hotchk155/noodlebox_io_board/matrix_io_board.brd

## EAGLE design matrix_io_board.brd (2020-02-26)

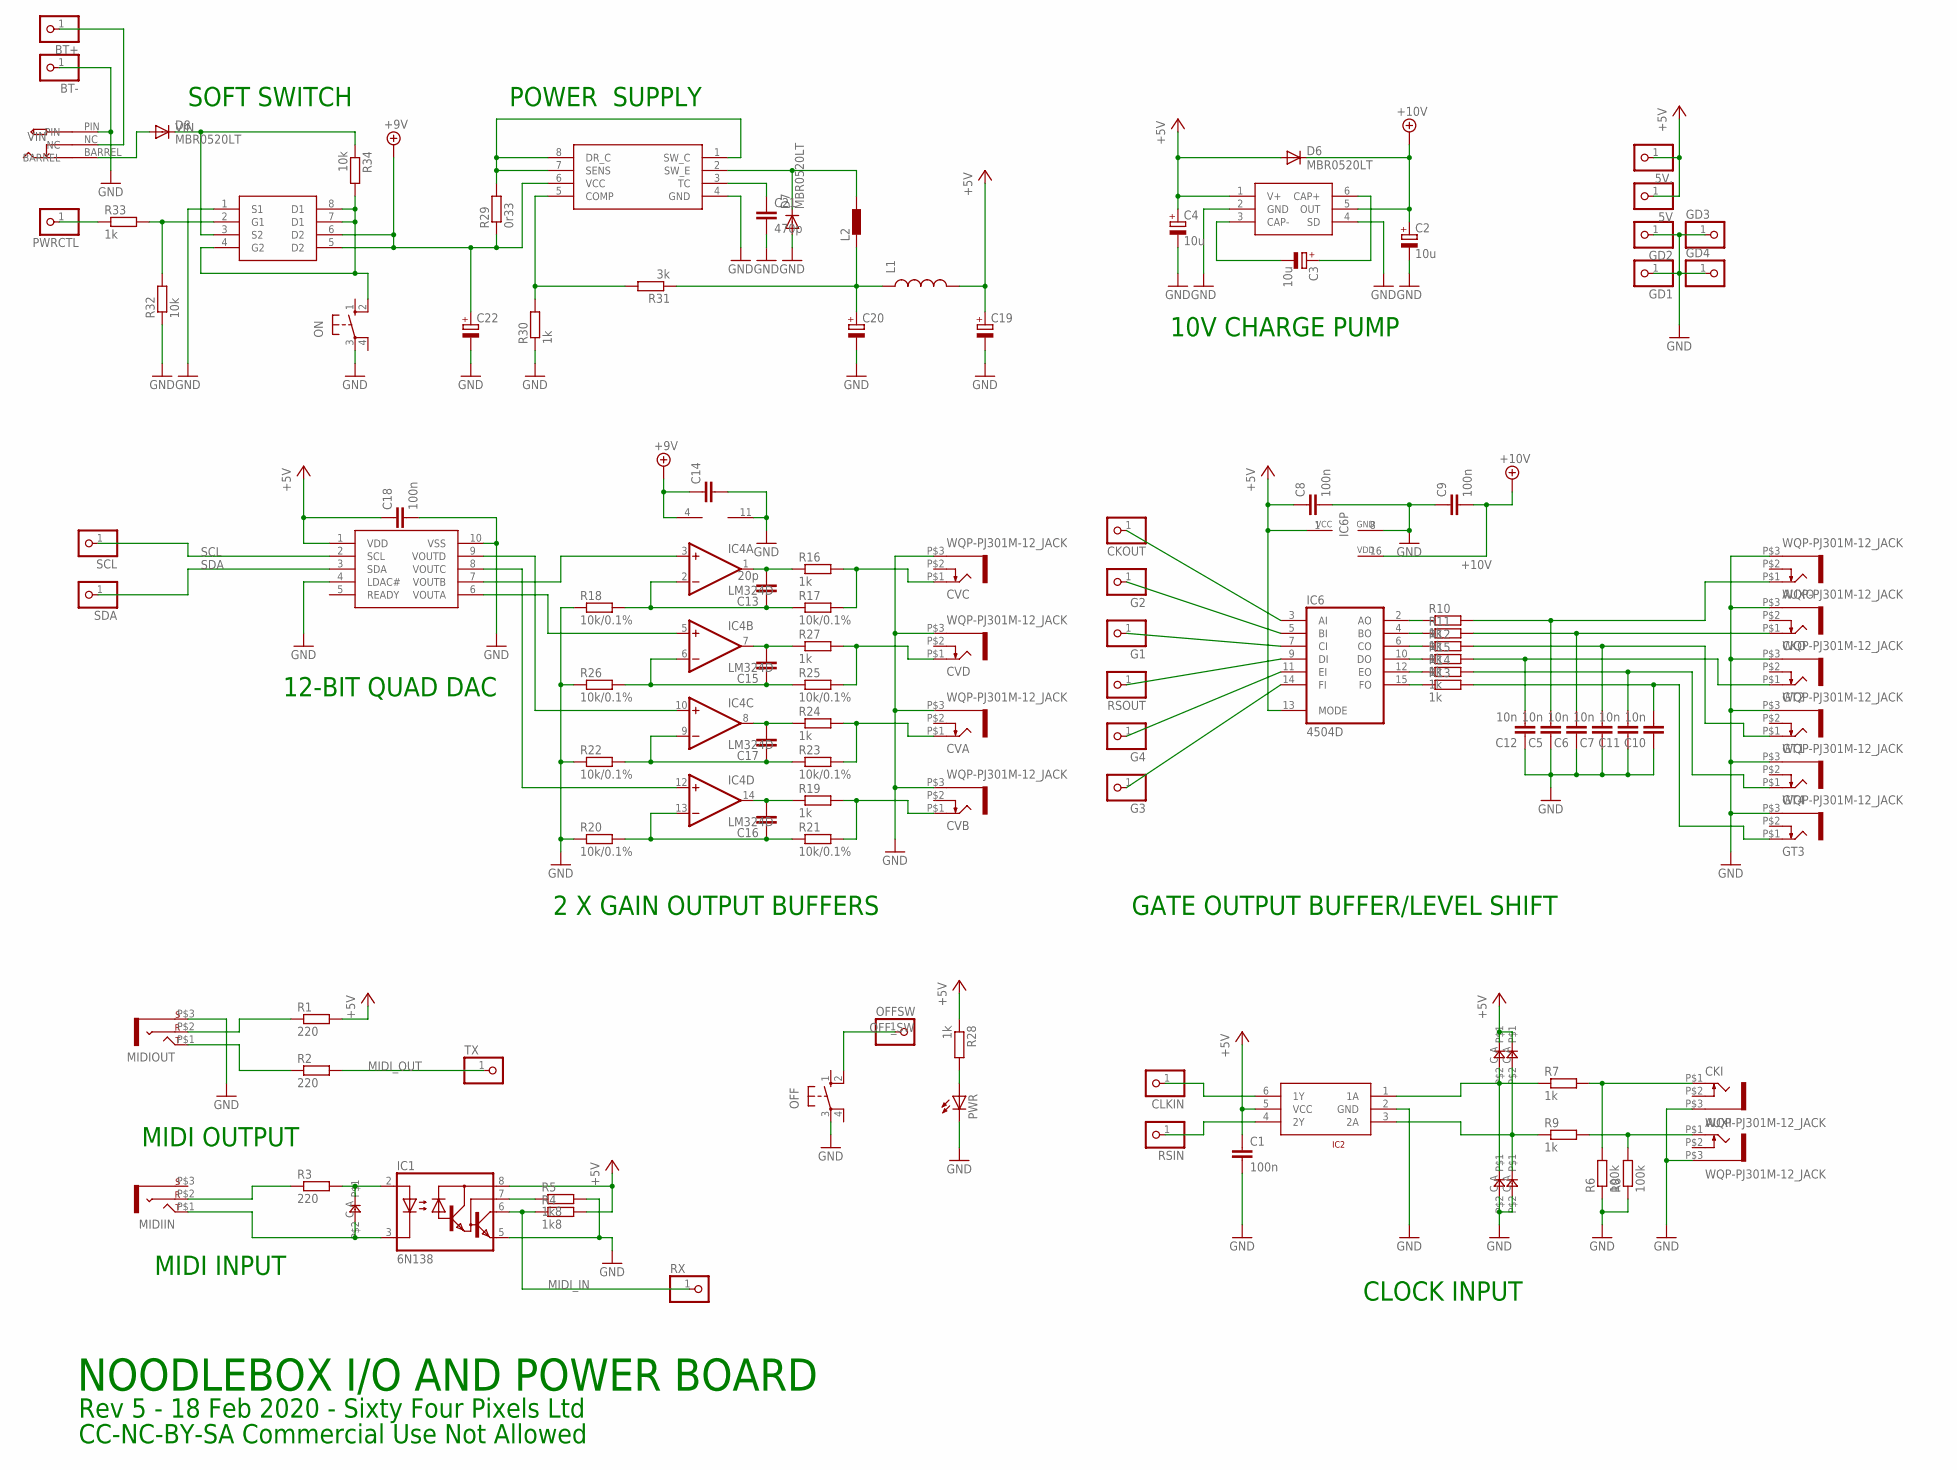
[picture p1: schematic matrix_io_board.sch]

Parts:
5V, 5V.: PINHD-1X1; 1X01
AUXI: WQP-PJ301M-12_JACK
AUXO: WQP-PJ301M-12_JACK
BT+: PINHD-1X1; 1X01
BT-: PINHD-1X1; 1X01
C1, C8, C9, C18: 100n; C0805
C2, C3, C4: 10u; SMC_A
C5, C6, C7, C10, C11, C12: 10n; C0805
C13: 20p; C0805
C14, C15, C16, C17: C-EUC0805; C0805
C19, C20, C22: CPOL-EUD; PANASONIC_D
C21: 470p; C0805
CKI: WQP-PJ301M-12_JACK
CKO: WQP-PJ301M-12_JACK
CKOUT: PINHD-1X1; 1X01
CLKIN: PINHD-1X1; 1X01
CVA: WQP-PJ301M-12_JACK
CVB: WQP-PJ301M-12_JACK
CVC: WQP-PJ301M-12_JACK
CVD: WQP-PJ301M-12_JACK
D1, D2, D3, D4, D5: 0805DIODE
D6, D7, D8: MBR0520LT; SOD123
DC: PWR_SOCKET_2_1MM
G1, G2, G3, G4: PINHD-1X1; 1X01
GD1, GD2, GD3, GD4: PINHD-1X1; 1X01
GT1, GT2, GT3, GT4: WQP-PJ301M-12_JACK
IC1: 6N138; DIL08
IC2: SN74LVC2G14; DBV_R-PDSO-G6
IC3: LM27675M5_CHARGEPUMP; SOT23-6
IC4: LM324D; SO14
IC5: MCP4728_QUAD_DAC; MSOP10
IC6: 4504D; SO16
IC7: SP34063A_BOOST_REG; SOIC8
IC8: FDS8958B; SOIC8
L1: INDUCTOR1210; 1210
L2: NB_IND; DR1030
MIDIIN: THONKICONN_STEREO; WQP-PJ301M-ST
MIDIOUT: THONKICONN_STEREO; WQP-PJ301M-ST
OFF: 10-XX; B3F-10XX
OFFSW: PINHD-1X1; 1X01
ON: 10-XX; B3F-10XX
PWR: LED3MM
PWRCTL: PINHD-1X1; 1X01
R1, R2, R3: 220; R0805
R4, R5: 1k8; R0805
R6, R8: 100k; R0805
R7, R9, R10, R11, R12, R13, R14, R15, R16, R19, R24, R27, R28, R30, R33: 1k; R0805
R17, R18, R20, R21, R22, R23, R25, R26: 10k/0.1%; R0805
R29: 0r33; R0805
R31: 3k; R0805
R32, R34: 10k; R0805
RSIN: PINHD-1X1; 1X01
RSOUT: PINHD-1X1; 1X01
RX: PINHD-1X1; 1X01
SCL: PINHD-1X1; 1X01
SDA: PINHD-1X1; 1X01
TX: PINHD-1X1; 1X01

Connections:
+5V: 5V.1, 5V..1, C1.1, C4.+, C8.1, C18.1, C19.+, D3.A, D4.A, D6.A, IC1.8 (VCC), IC2.5 (VCC), IC3.1 (V+), IC5.1 (VDD), IC6.1 (VCC), IC6.13 (MODE), L1.2, R1.2, R4.2, R28.1
+9V: C14.1, C22.+, IC4.4 (V+), IC7.6 (VCC), IC8.5 (D2), IC8.6 (D2), R29.1
+10V: C2.+, C9.2, D6.C, IC3.5 (OUT), IC6.16 (VDD)
AUXGATE: IC6.9 (DI), RSOUT.1
CLKOUT: CKOUT.1, IC6.3 (AI)
GATE1: G3.1, IC6.14 (FI)
GATE2: G2.1, IC6.5 (BI)
GATE3: G1.1, IC6.7 (CI)
GATE4: G4.1, IC6.11 (EI)
GND: AUXI.P$3 (1), AUXO.P$3 (1), BT-.1, C1.2, C2.-, C4.-, C5.1, C6.1, C7.1, C8.2, C9.1, C10.1, C11.1, C12.1, C14.2, C18.2, C19.-, C20.-, C21.2, C22.-, CKI.P$3 (1), CKO.P$3 (1), CVA.P$3 (1), CVB.P$3 (1), CVC.P$3 (1), CVD.P$3 (1), D2.C, D5.C, D7.A, DC.PIN, GD1.1, GD2.1, GD3.1, GD4.1, GT1.P$3 (1), GT2.P$3 (1), GT3.P$3 (1), GT4.P$3 (1), IC1.5 (GND), IC2.2 (GND), IC3.2 (GND), IC3.4 (SD), IC4.11 (V-), IC5.4 (LDAC#), IC5.10 (VSS), IC6.8 (GND), IC7.4 (GND), IC8.1 (S1), MIDIOUT.P$3 (S), OFF.3, ON.3, PWR.K (C), R5.2, R6.1, R8.1, R18.1, R20.1, R22.1, R26.1, R30.1, R32.1
MIDI_IN: IC1.6 (VO), R4.1, RX.1
MIDI_OUT: R2.2, TX.1
unnamed: MIDIOUT.P$2 (R), R1.1
unnamed: D1.A, IC1.2 (A), R3.2
unnamed: IC4.3 (+IN), IC5.7 (VOUTB)
unnamed: D1.C, IC1.3 (C), MIDIIN.P$1 (T)
unnamed: IC1.7 (VB), R5.1
unnamed: MIDIOUT.P$1 (T), R2.1
unnamed: MIDIIN.P$2 (R), R3.1
unnamed: CVC.P$1 (2), R16.2, R17.2
unnamed: CVD.P$1 (2), R25.2, R27.2
unnamed: CVB.P$1 (2), R19.2, R21.2
unnamed: CVA.P$1 (2), R23.2, R24.2
unnamed: C13.2, IC4.1 (OUT), R16.1
unnamed: C15.2, IC4.7 (OUT), R27.1
unnamed: C17.2, IC4.8 (OUT), R24.1
unnamed: C16.2, IC4.14 (OUT), R19.1
unnamed: BT+.1, DC.NC
unnamed: C16.1, IC4.13 (-IN), R20.2, R21.1
unnamed: C17.1, IC4.9 (-IN), R22.2, R23.1
unnamed: IC6.10 (DO), R15.1
unnamed: C15.1, IC4.6 (-IN), R25.1, R26.2
unnamed: C13.1, IC4.2 (-IN), R17.1, R18.2
unnamed: CLKIN.1, IC2.6 (1Y)
unnamed: AUXI.P$1 (2), R8.2, R9.2
unnamed: IC2.4 (2Y), RSIN.1
unnamed: D4.C, D5.A, IC2.3 (2A), R9.1
unnamed: C12.2, GT2.P$1 (2), R15.2
unnamed: IC4.5 (+IN), IC5.6 (VOUTA)
unnamed: IC4.10 (+IN), IC5.9 (VOUTD)
unnamed: IC4.12 (+IN), IC5.8 (VOUTC)
unnamed: IC7.1 (SW_C), IC7.7 (SENS), IC7.8 (DR_C), R29.2
unnamed: IC7.5 (COMP), R30.2, R31.2
unnamed: C21.1, IC7.3 (TC)
unnamed: D7.C, IC7.2 (SW_E), L2.2
unnamed: D8.A, DC.BARREL
unnamed: IC6.2 (AO), R10.1
unnamed: C3.+, IC3.6 (CAP+)
unnamed: C3.-, IC3.3 (CAP-)
unnamed: IC6.4 (BO), R11.1
unnamed: IC6.6 (CO), R12.1
unnamed: IC6.12 (EO), R14.1
unnamed: AUXO.P$1 (2), C5.2, R10.2
unnamed: C6.2, CKO.P$1 (2), R11.2
unnamed: C7.2, GT1.P$1 (2), R12.2
unnamed: C11.2, GT4.P$1 (2), R14.2
unnamed: C10.2, GT3.P$1 (2), R13.2
unnamed: IC6.15 (FO), R13.1
unnamed: C20.+, L1.1, L2.1, R31.1
unnamed: D2.A, D3.C, IC2.1 (1A), R7.1
unnamed: CKI.P$1 (2), R6.2, R7.2
unnamed: PWR.A, R28.2
unnamed: IC8.4 (G2), IC8.7 (D1), IC8.8 (D1), ON.2 (S1), R34.2
unnamed: IC8.2 (G1), R32.2, R33.2
OFF_SW: OFF.2 (S1), OFFSW.1
PWR_CTRL: PWRCTL.1, R33.1
SCL: IC5.2 (SCL), SCL.1
SDA: IC5.3 (SDA), SDA.1
VIN: D8.C, IC8.3 (S2), R34.1

Notes on the sheet:
POWER SUPPLY
SOFT SWITCH
2 X GAIN OUTPUT BUFFERS
12-BIT QUAD DAC
GATE OUTPUT BUFFER/LEVEL SHIFT
10V CHARGE PUMP
MIDI INPUT
MIDI OUTPUT
CLOCK INPUT
NOODLEBOX I/O AND POWER BOARD
Rev 5 - 18 Feb 2020 - Sixty Four Pixels Ltd
CC-NC-BY-SA Commercial Use Not Allowed

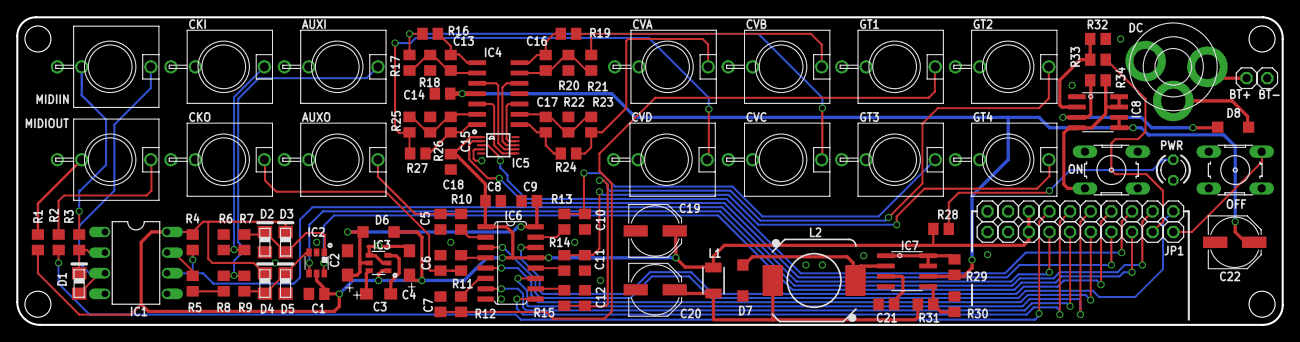
[picture p2: board matrix_io_board.brd from above]

Board: 2 copper layers, 155.7 x 37.8 mm, 114 parts (0 on the bottom side), 69 nets.
