hotchk155/noodlebox_io_board/lower-board.brd

## EAGLE design lower-board.brd (2018-07-10)

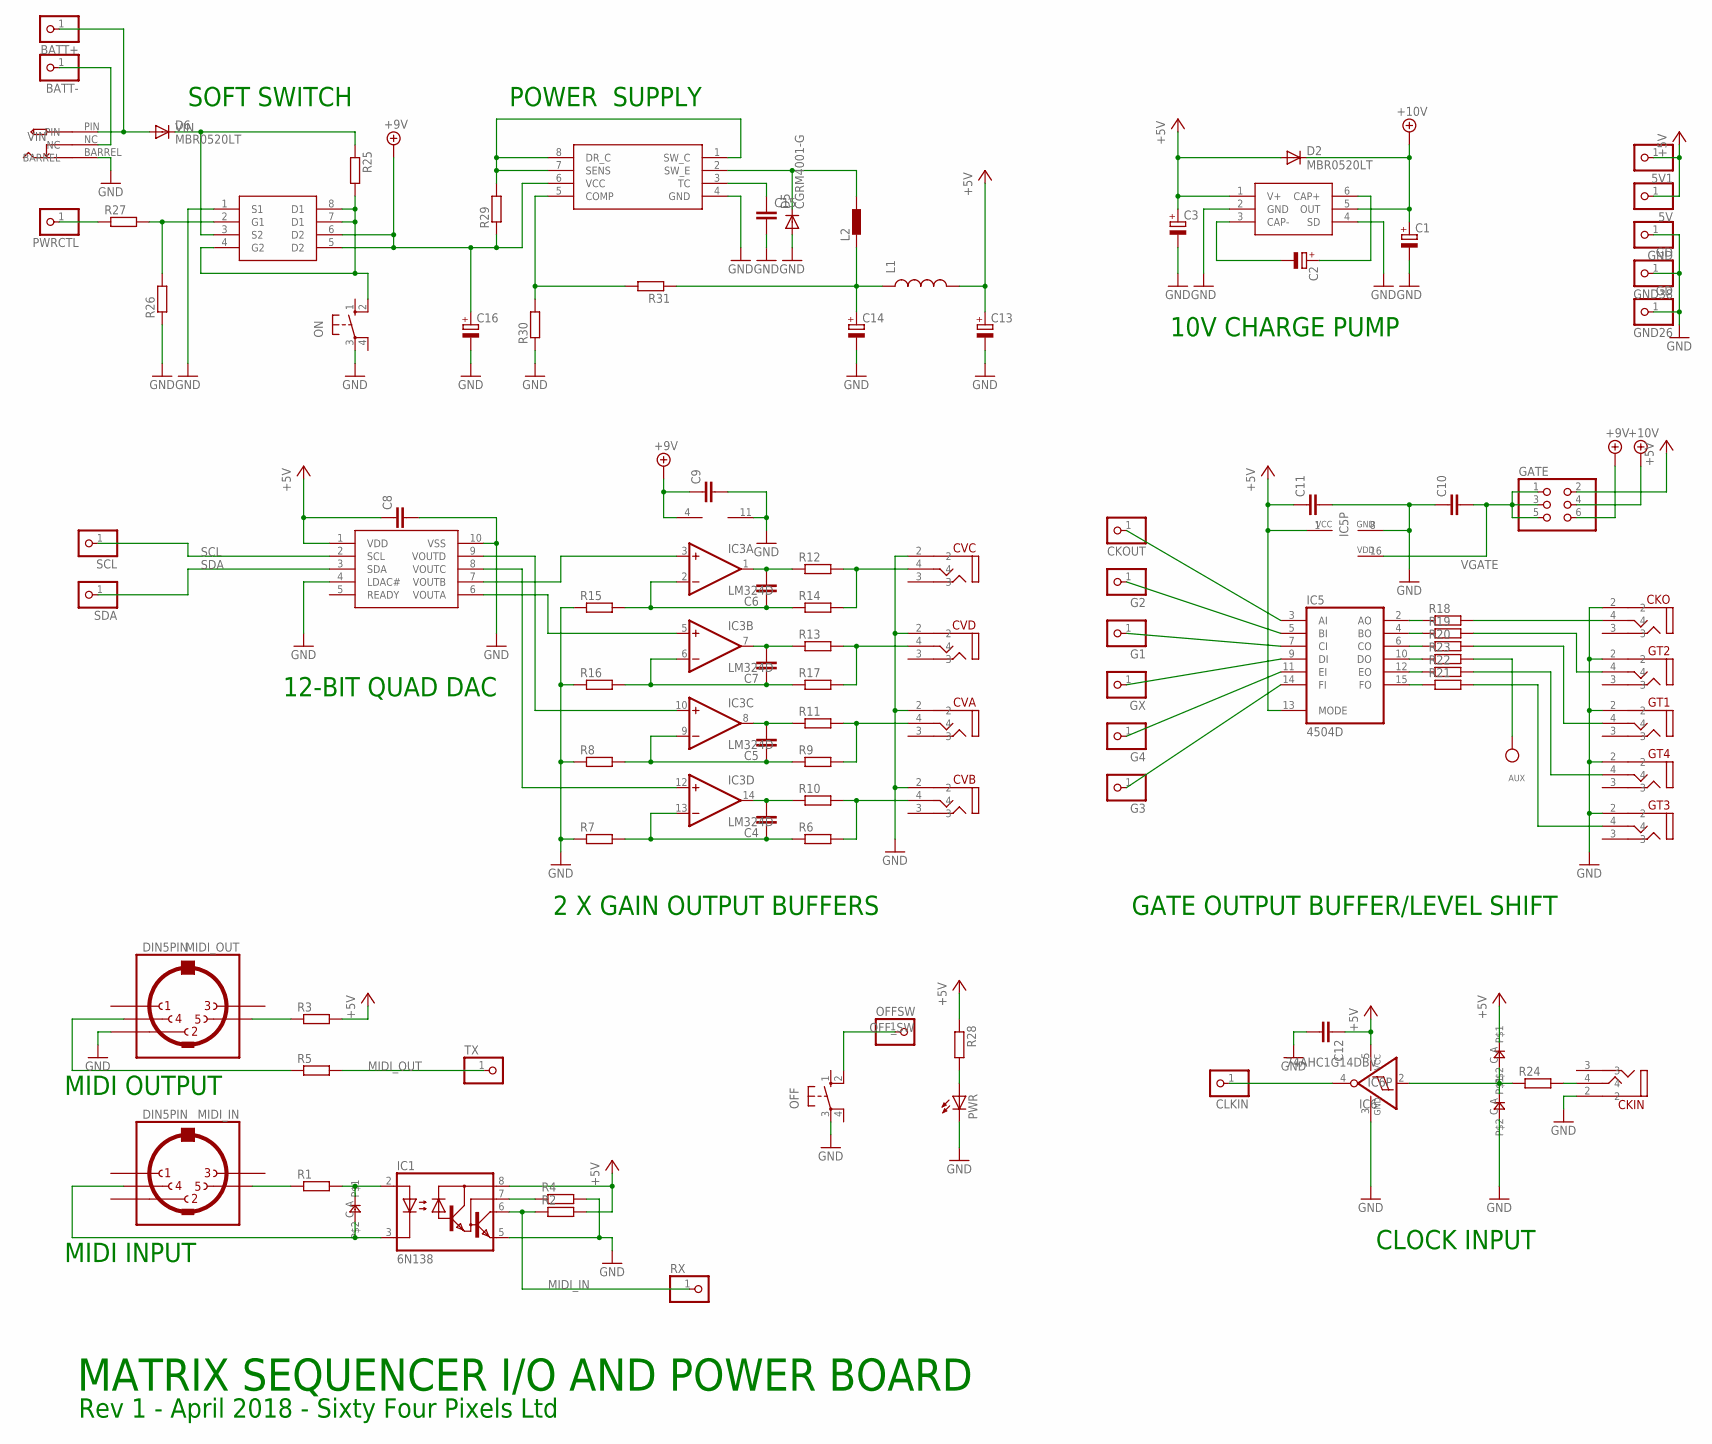
[picture p3: schematic lower-board.sch]

Parts:
5V, 5V1: PINHD-1X1; 1X01
AUX: TESTPOINTROUND2MM; TESTPOINT_ROUND_2MM
BATT+: PINHD-1X1; 1X01
BATT-: PINHD-1X1; 1X01
C1, C2, C3: CPOL-EUSMCA; SMC_A
C4, C5, C6, C7, C8, C9, C10, C11, C12, C15: C-EUC0805; C0805
C13, C14, C16: CPOL-EUE2.5-7; E2,5-7
CKIN: VERTICAL_3_5MM_SOCKET
CKO: VERTICAL_3_5MM_SOCKET
CKOUT: PINHD-1X1; 1X01
CLKIN: PINHD-1X1; 1X01
CVA: VERTICAL_3_5MM_SOCKET
CVB: VERTICAL_3_5MM_SOCKET
CVC: VERTICAL_3_5MM_SOCKET
CVD: VERTICAL_3_5MM_SOCKET
D1, D3, D4: 0805DIODE
D2, D6: MBR0520LT; SOD123
D5: CGRM4001-G; SOD-123_MINI-SMA
G1, G2, G3, G4: PINHD-1X1; 1X01
GATE: PINHD-2X3; 2X03
GND: PINHD-1X1; 1X01
GND26, GND38: GD; 1X01
GT1, GT2, GT3, GT4: VERTICAL_3_5MM_SOCKET
GX: PINHD-1X1; 1X01
IC1: 6N138; DIL08
IC2: LM27675M5_CHARGEPUMP; SOT23-6
IC3: LM324D; SO14
IC4: MCP4728_QUAD_DAC; MSOP10
IC5: 4504D; SO16
IC6: 74AHC1G14DBV; SOT23-5
IC7: FDS8958B; SOIC8
IC8: SP34063A_BOOST_REG; SOIC8
L1: INDUCTOR1210; 1210
L2: DR1030
MIDI_IN: DIN5PIN; EDGEDIN
MIDI_OUT: DIN5PIN; EDGEDIN
OFF: 10-XX; B3F-10XX
OFFSW: PINHD-1X1; 1X01
ON: 10-XX; B3F-10XX
PWR: LED3MM
PWRCTL: PINHD-1X1; 1X01
R1, R2, R3, R4, R5, R6, R7, R8, R9, R10, R11, R12, R13, R14, R15, R16, R17, R18, R19, R20, R21, R22, R23, R24, R25, R26, R27, R28, R29, R30, R31: R-EU_R0805; R0805
RX: PINHD-1X1; 1X01
SCL: PINHD-1X1; 1X01
SDA: PINHD-1X1; 1X01
TX: PINHD-1X1; 1X01
U$1: PWR_SOCKET_2_1MM

Connections:
+5V: 5V.1, 5V1.1, C3.+, C8.1, C11.1, C12.1, C13.+, D2.A, D3.A, GATE.2, IC1.8 (VCC), IC2.1 (V+), IC4.1 (VDD), IC5.1 (VCC), IC5.13 (MODE), IC6.5 (VCC), L1.2, R2.2, R3.2, R28.1
+9V: C9.1, C16.+, GATE.6, IC3.4 (V+), IC7.5 (D2), IC7.6 (D2), IC8.6 (VCC), R29.1
+10V: C1.+, D2.C, GATE.4, IC2.5 (OUT)
AUXGATE: GX.1, IC5.9 (DI)
CLKIN: CLKIN.1, IC6.4 (O)
CLKOUT: CKOUT.1, IC5.3 (AI)
GATE1: G3.1, IC5.14 (FI)
GATE2: G2.1, IC5.5 (BI)
GATE3: G1.1, IC5.7 (CI)
GATE4: G4.1, IC5.11 (EI)
GND: C1.-, C3.-, C8.2, C9.2, C10.1, C11.2, C12.2, C13.-, C14.-, C15.2, C16.-, CKIN.2, CKO.2, CVA.2, CVB.2, CVC.2, CVD.2, D4.C, D5.A, GND.1, GND26.1, GND38.1, GT1.2, GT2.2, GT3.2, GT4.2, IC1.5 (GND), IC2.2 (GND), IC2.4 (SD), IC3.11 (V-), IC4.4 (LDAC#), IC4.10 (VSS), IC5.8 (GND), IC6.3 (GND), IC7.1 (S1), IC8.4 (GND), MIDI_OUT.2, OFF.3, ON.3, PWR.K (C), R4.2, R7.1, R8.1, R15.1, R16.1, R26.1, R30.1, U$1.BARREL
MIDI_IN: IC1.6 (VO), R2.1, RX.1
MIDI_OUT: R5.2, TX.1
unnamed: MIDI_OUT.5, R3.1
unnamed: D1.A, IC1.2 (A), R1.2
unnamed: IC3.3 (+IN), IC4.7 (VOUTB)
unnamed: D1.C, IC1.3 (C), MIDI_IN.4
unnamed: IC1.7 (VB), R4.1
unnamed: MIDI_OUT.4, R5.1
unnamed: MIDI_IN.5, R1.1
unnamed: CVC.4, R12.2, R14.2
unnamed: CVD.4, R13.2, R17.2
unnamed: CVB.4, R6.2, R10.2
unnamed: CVA.4, R9.2, R11.2
unnamed: C6.2, IC3.1 (OUT), R12.1
unnamed: C7.2, IC3.7 (OUT), R13.1
unnamed: C5.2, IC3.8 (OUT), R11.1
unnamed: C4.2, IC3.14 (OUT), R10.1
unnamed: C4.1, IC3.13 (-IN), R6.1, R7.2
unnamed: C5.1, IC3.9 (-IN), R8.2, R9.1
unnamed: C7.1, IC3.6 (-IN), R16.2, R17.1
unnamed: C6.1, IC3.2 (-IN), R14.1, R15.2
unnamed: IC3.5 (+IN), IC4.6 (VOUTA)
unnamed: IC3.10 (+IN), IC4.9 (VOUTD)
unnamed: IC3.12 (+IN), IC4.8 (VOUTC)
unnamed: IC8.1 (SW_C), IC8.7 (SENS), IC8.8 (DR_C), R29.2
unnamed: IC8.5 (COMP), R30.2, R31.2
unnamed: C15.1, IC8.3 (TC)
unnamed: D5.C, IC8.2 (SW_E), L2.2
unnamed: BATT+.1, D6.A, U$1.PIN
unnamed: IC5.2 (AO), R18.1
unnamed: C2.+, IC2.6 (CAP+)
unnamed: C2.-, IC2.3 (CAP-)
unnamed: IC5.4 (BO), R19.1
unnamed: IC5.6 (CO), R20.1
unnamed: IC5.10 (DO), R23.1
unnamed: IC5.12 (EO), R22.1
unnamed: CKO.4, R18.2
unnamed: GT2.4, R19.2
unnamed: GT1.4, R20.2
unnamed: GT4.4, R22.2
unnamed: GT3.4, R21.2
unnamed: IC5.15 (FO), R21.1
unnamed: AUX.P$1, R23.2
unnamed: C14.+, L1.1, L2.1, R31.1
unnamed: D3.C, D4.A, IC6.2 (I), R24.1
unnamed: CKIN.4, R24.2
unnamed: PWR.A, R28.2
unnamed: IC7.4 (G2), IC7.7 (D1), IC7.8 (D1), ON.2 (S1), R25.2
unnamed: IC7.2 (G1), R26.2, R27.2
unnamed: BATT-.1, U$1.NC
OFF_SW: OFF.2 (S1), OFFSW.1
PWR_CTRL: PWRCTL.1, R27.1
SCL: IC4.2 (SCL), SCL.1
SDA: IC4.3 (SDA), SDA.1
VGATE: C10.2, GATE.1, GATE.3, GATE.5, IC5.16 (VDD)
VIN: D6.C, IC7.3 (S2), R25.1

Notes on the sheet:
POWER SUPPLY
SOFT SWITCH
2 X GAIN OUTPUT BUFFERS
12-BIT QUAD DAC
GATE OUTPUT BUFFER/LEVEL SHIFT
10V CHARGE PUMP
MIDI INPUT
MIDI OUTPUT
CLOCK INPUT
MATRIX SEQUENCER I/O AND POWER BOARD
Rev 1 - April 2018 - Sixty Four Pixels Ltd

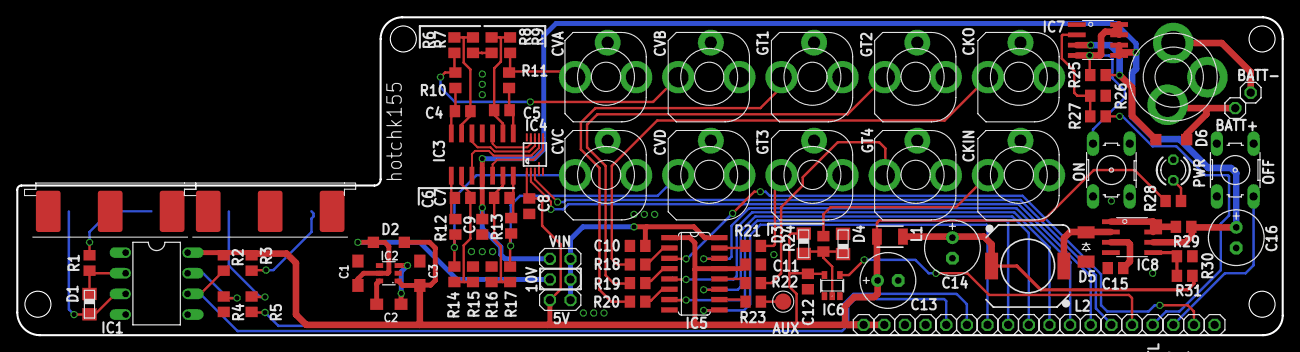
[picture p4: board lower-board.brd from above]

Board: 2 copper layers, 155.7 x 39.1 mm, 101 parts (0 on the bottom side), 67 nets.
