hotchk155/noodlebox_io_board/matrix_io_stencil/matrix_io_stencil.brd

## EAGLE design matrix_io_stencil/matrix_io_stencil.brd (2022-04-09)

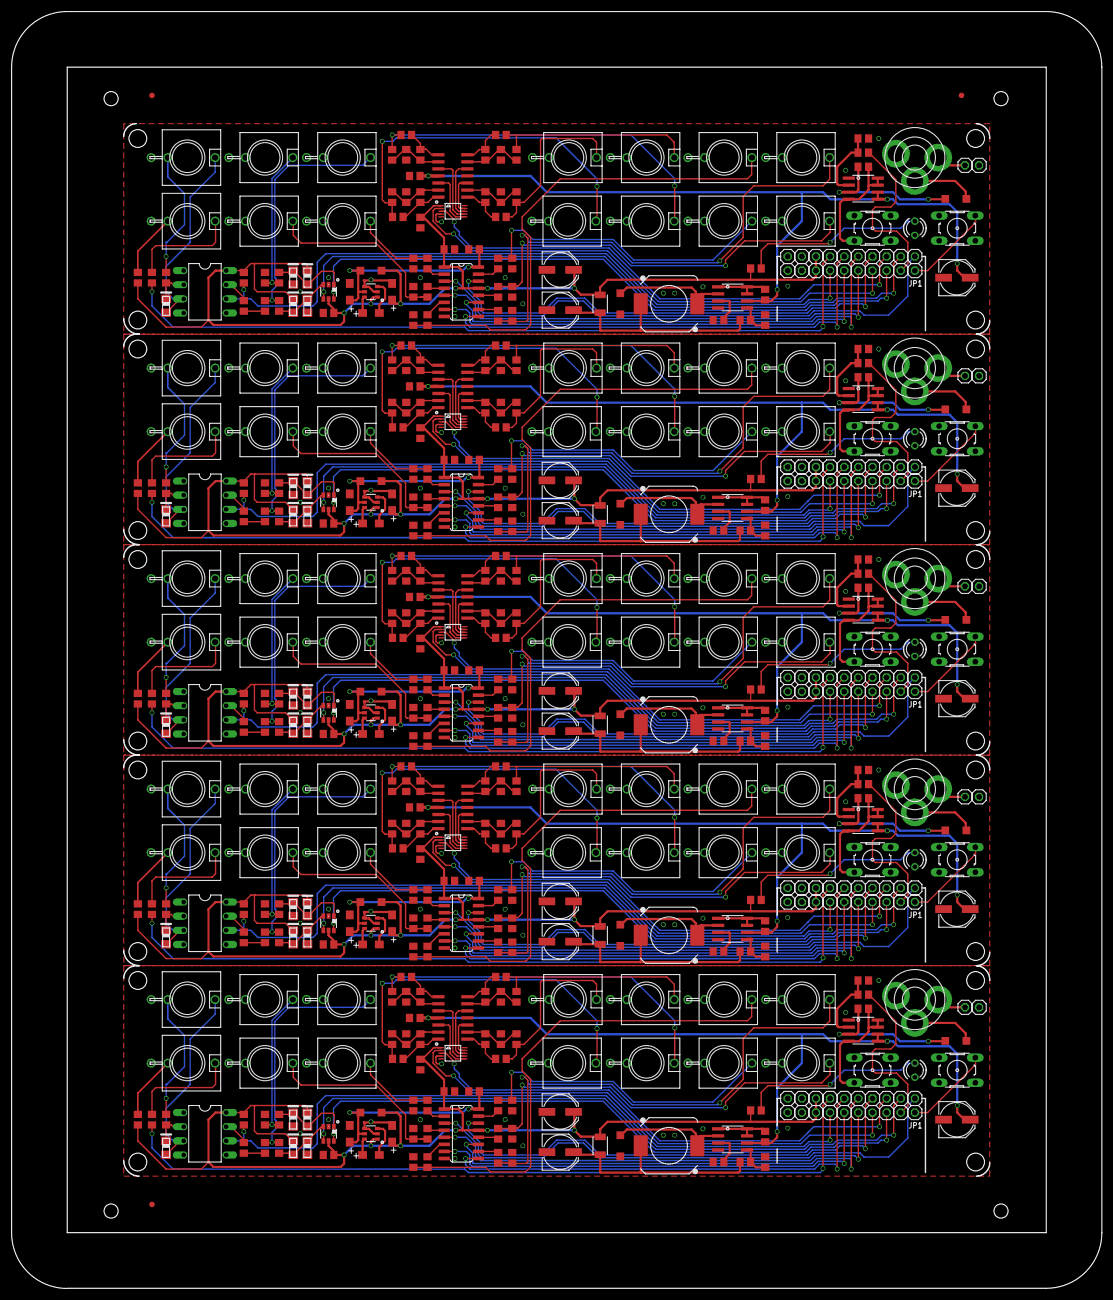
[picture p5: board matrix_io_stencil.brd from above]

Board: 2 copper layers, 196.0 x 229.6 mm, 573 parts (0 on the bottom side), 345 nets.

Parts:
5V, 5V1, 5V2, 5V3, 5V4, 5V., 5V.1, 5V.2, 5V.3, 5V.4: 1X01
AUXI, AUXI1, AUXI2, AUXI3, AUXI4: WQP-PJ301M-12_JACK
AUXO, AUXO1, AUXO2, AUXO3, AUXO4: WQP-PJ301M-12_JACK
BT+, BT+1, BT+2, BT+3, BT+4: 1X01
BT-, BT-1, BT-2, BT-3, BT-4: 1X01
C1, C8, C9, C18, C24, C31, C32, C34, C46, C53, C54, C56, C68, C75, C76, C78, C90, C97, C98, C100: 100n; C0805
C2, C3, C4, C28, C29, C30, C50, C51, C52, C72, C73, C74, C94, C95, C96: 10u; SMC_A
C5, C6, C7, C10, C11, C12, C39, C40, C41, C42, C43, C44, C61, C62, C63, C64, C65, C66, C83, C84, C85, C86, C87, C88, C105, C106, C107, C108, C109, C110: 10n; C0805
C13, C35, C57, C79, C101: 20p; C0805
C14, C15, C16, C17, C23, C36, C37, C38, C45, C58, C59, C60, C67, C80, C81, C82, C89, C102, C103, C104: C0805
C19, C20, C22, C25, C27, C33, C47, C49, C55, C69, C71, C77, C91, C93, C99: PANASONIC_D
C21, C26, C48, C70, C92: 470p; C0805
CKI, CKI1, CKI2, CKI3, CKI4: WQP-PJ301M-12_JACK
CKO, CKO1, CKO2, CKO3, CKO4: WQP-PJ301M-12_JACK
CKOUT, CKOUT1, CKOUT2, CKOUT3, CKOUT4: 1X01
CLKIN, CLKIN1, CLKIN2, CLKIN3, CLKIN4: 1X01
CVA, CVA1, CVA2, CVA3, CVA4: WQP-PJ301M-12_JACK
CVB, CVB1, CVB2, CVB3, CVB4: WQP-PJ301M-12_JACK
CVC, CVC1, CVC2, CVC3, CVC4: WQP-PJ301M-12_JACK
CVD, CVD1, CVD2, CVD3, CVD4: WQP-PJ301M-12_JACK
D1, D2, D3, D4, D5, D9, D11, D12, D14, D15, D17, D19, D20, D22, D23, D25, D27, D28, D30, D31, D33, D35, D36, D38, D39: 0805DIODE
D6, D7, D8, D10, D13, D16, D18, D21, D24, D26, D29, D32, D34, D37, D40: MBR0520LT; SOD123
DC, DC1, DC2, DC3, DC4: PWR_SOCKET_2_1MM
E$1, E$2, E$3: FIDUCIAL_1MM
G1, G2, G3, G4, G5, G6, G7, G8, G9, G10, G11, G12, G13, G14, G15, G16, G17, G18, G19, G20: 1X01
GD1, GD2, GD3, GD4, GD5, GD6, GD7, GD8, GD9, GD10, GD11, GD12, GD13, GD14, GD15, GD16, GD17, GD18, GD19, GD20: 1X01
GT1, GT2, GT3, GT4, GT5, GT6, GT7, GT8, GT9, GT10, GT11, GT12, GT13, GT14, GT15, GT16, GT17, GT18, GT19, GT20: WQP-PJ301M-12_JACK
IC1, IC10, IC18, IC26, IC34: 6N138; DIL08
IC2, IC16, IC24, IC32, IC40: SN74LVC2G14; DBV_R-PDSO-G6
IC3, IC13, IC21, IC29, IC37: LM27675M5_CHARGEPUMP; SOT23-6
IC4, IC9, IC17, IC25, IC33: LM324D; SO14
IC5, IC11, IC19, IC27, IC35: MCP4728_QUAD_DAC; MSOP10
IC6, IC14, IC22, IC30, IC38: 4504D; SO16
IC7, IC12, IC20, IC28, IC36: SP34063A_BOOST_REG; SOIC8
IC8, IC15, IC23, IC31, IC39: FDS8958B; SOIC8
L1, L3, L5, L7, L9: 1210
L2, L4, L6, L8, L10: DR1030
MIDIIN, MIDIIN1, MIDIIN2, MIDIIN3, MIDIIN4: THONKICONN_STEREO; WQP-PJ301M-ST
MIDIOUT, MIDIOUT1, MIDIOUT2, MIDIOUT3, MIDIOUT4: THONKICONN_STEREO; WQP-PJ301M-ST
OFF, OFF1, OFF2, OFF3, OFF4: B3F-10XX
OFFSW, OFFSW1, OFFSW2, OFFSW3, OFFSW4: 1X01
ON, ON1, ON2, ON3, ON4: B3F-10XX
PWR, PWR1, PWR2, PWR3, PWR4: LED3MM
PWRCTL, PWRCTL1, PWRCTL2, PWRCTL3, PWRCTL4: 1X01
R1, R2, R3, R35, R38, R39, R69, R72, R73, R103, R106, R107, R137, R140, R141: 220; R0805
R4, R5, R36, R37, R70, R71, R104, R105, R138, R139: 1k8; R0805
R6, R8, R65, R68, R99, R102, R133, R136, R167, R170: 100k; R0805
R7, R9, R10, R11, R12, R13, R14, R15, R16, R19, R24, R27, R28, R30, R33, R40, R41, R42, R43, R53, R55, R56, R57, R58, R59, R60, R61, R63, R66, R67, R74, R75, R76, R77, R87, R89, R90, R91, R92, R93, R94, R95, R97, R100, R101, R108, R109, R110, R111, R121, R123, R124, R125, R126, R127, R128, R129, R131, R134, R135, R142, R143, R144, R145, R155, R157, R158, R159, R160, R161, R162, R163, R165, R168, R169: 1k; R0805
R17, R18, R20, R21, R22, R23, R25, R26, R44, R45, R46, R47, R48, R49, R50, R51, R78, R79, R80, R81, R82, R83, R84, R85, R112, R113, R114, R115, R116, R117, R118, R119, R146, R147, R148, R149, R150, R151, R152, R153: 10k/0.1%; R0805
R29, R52, R86, R120, R154: 0r33; R0805
R31, R54, R88, R122, R156: 3k; R0805
R32, R34, R62, R64, R96, R98, R130, R132, R164, R166: 10k; R0805
RSIN, RSIN1, RSIN2, RSIN3, RSIN4: 1X01
RSOUT, RSOUT1, RSOUT2, RSOUT3, RSOUT4: 1X01
RX, RX1, RX2, RX3, RX4: 1X01
SCL, SCL1, SCL2, SCL3, SCL4: 1X01
SDA, SDA1, SDA2, SDA3, SDA4: 1X01
TX, TX1, TX2, TX3, TX4: 1X01

Connections:
+5V: 5V.1, 5V..1, C1.1, C4.+, C8.1, C18.1, C19.+, D3.A, D4.A, D6.A, IC1.8, IC2.5, IC3.1, IC5.1, IC6.1, IC6.13, L1.2, R1.2, R4.2, R28.1
+5V1: 5V1.1, 5V.1.1, C24.1, C30.+, C31.1, C33.+, C34.1, D10.A, D11.A, D14.A, IC10.8, IC11.1, IC13.1, IC14.1, IC14.13, IC16.5, L3.2, R37.2, R38.2, R61.1
+5V2: 5V2.1, 5V.2.1, C46.1, C52.+, C53.1, C55.+, C56.1, D18.A, D19.A, D22.A, IC18.8, IC19.1, IC21.1, IC22.1, IC22.13, IC24.5, L5.2, R71.2, R72.2, R95.1
+5V3: 5V3.1, 5V.3.1, C68.1, C74.+, C75.1, C77.+, C78.1, D26.A, D27.A, D30.A, IC26.8, IC27.1, IC29.1, IC30.1, IC30.13, IC32.5, L7.2, R105.2, R106.2, R129.1
+5V4: 5V4.1, 5V.4.1, C90.1, C96.+, C97.1, C99.+, C100.1, D34.A, D35.A, D38.A, IC34.8, IC35.1, IC37.1, IC38.1, IC38.13, IC40.5, L9.2, R139.2, R140.2, R163.1
+9V: C14.1, C22.+, IC4.4, IC7.6, IC8.5, IC8.6, R29.1
+9V1: C23.1, C25.+, IC9.4, IC12.6, IC15.5, IC15.6, R52.1
+9V2: C45.1, C47.+, IC17.4, IC20.6, IC23.5, IC23.6, R86.1
+9V3: C67.1, C69.+, IC25.4, IC28.6, IC31.5, IC31.6, R120.1
+9V4: C89.1, C91.+, IC33.4, IC36.6, IC39.5, IC39.6, R154.1
+10V: C2.+, C9.2, D6.C, IC3.5, IC6.16
+10V1: C29.+, C32.2, D10.C, IC13.5, IC14.16
+10V2: C51.+, C54.2, D18.C, IC21.5, IC22.16
+10V3: C73.+, C76.2, D26.C, IC29.5, IC30.16
+10V4: C95.+, C98.2, D34.C, IC37.5, IC38.16
AUXGATE: IC6.9, RSOUT.1
AUXGATE1: IC14.9, RSOUT1.1
AUXGATE2: IC22.9, RSOUT2.1
AUXGATE3: IC30.9, RSOUT3.1
AUXGATE4: IC38.9, RSOUT4.1
CLKOUT: CKOUT.1, IC6.3
CLKOUT1: CKOUT1.1, IC14.3
CLKOUT2: CKOUT2.1, IC22.3
CLKOUT3: CKOUT3.1, IC30.3
CLKOUT4: CKOUT4.1, IC38.3
GATE1: G3.1, IC6.14
GATE2: G2.1, IC6.5
GATE3: G1.1, IC6.7
GATE4: G4.1, IC6.11
GATE5: G5.1, IC14.14
GATE6: G6.1, IC14.5
GATE7: G7.1, IC14.7
GATE8: G8.1, IC14.11
GATE9: G9.1, IC22.14
GATE10: G10.1, IC22.5
GATE11: G11.1, IC22.7
GATE12: G12.1, IC22.11
GATE13: G13.1, IC30.14
GATE14: G14.1, IC30.5
GATE15: G15.1, IC30.7
GATE16: G16.1, IC30.11
GATE17: G17.1, IC38.14
GATE18: G18.1, IC38.5
GATE19: G19.1, IC38.7
GATE20: G20.1, IC38.11
GND: AUXI.P$3, AUXO.P$3, BT-.1, C1.2, C2.-, C4.-, C5.1, C6.1, C7.1, C8.2, C9.1, C10.1, C11.1, C12.1, C14.2, C18.2, C19.-, C20.-, C21.2, C22.-, CKI.P$3, CKO.P$3, CVA.P$3, CVB.P$3, CVC.P$3, CVD.P$3, D2.C, D5.C, D7.A, DC.PIN, GD1.1, GD2.1, GD3.1, GD4.1, GT1.P$3, GT2.P$3, GT3.P$3, GT4.P$3, IC1.5, IC2.2, IC3.2, IC3.4, IC4.11, IC5.4, IC5.10, IC6.8, IC7.4, IC8.1, MIDIOUT.P$3, OFF.3, ON.3, PWR.K, R5.2, R6.1, R8.1, R18.1, R20.1, R22.1, R26.1, R30.1, R32.1
GND1: AUXI1.P$3, AUXO1.P$3, BT-1.1, C23.2, C24.2, C25.-, C26.2, C27.-, C29.-, C30.-, C31.2, C32.1, C33.-, C34.2, C39.1, C40.1, C41.1, C42.1, C43.1, C44.1, CKI1.P$3, CKO1.P$3, CVA1.P$3, CVB1.P$3, CVC1.P$3, CVD1.P$3, D12.C, D15.C, D16.A, DC1.PIN, GD5.1, GD6.1, GD7.1, GD8.1, GT5.P$3, GT6.P$3, GT7.P$3, GT8.P$3, IC9.11, IC10.5, IC11.4, IC11.10, IC12.4, IC13.2, IC13.4, IC14.8, IC15.1, IC16.2, MIDIOUT1.P$3, OFF1.3, ON1.3, PWR1.K, R36.2, R48.1, R49.1, R50.1, R51.1, R53.1, R64.1, R65.1, R68.1
GND2: AUXI2.P$3, AUXO2.P$3, BT-2.1, C45.2, C46.2, C47.-, C48.2, C49.-, C51.-, C52.-, C53.2, C54.1, C55.-, C56.2, C61.1, C62.1, C63.1, C64.1, C65.1, C66.1, CKI2.P$3, CKO2.P$3, CVA2.P$3, CVB2.P$3, CVC2.P$3, CVD2.P$3, D20.C, D23.C, D24.A, DC2.PIN, GD9.1, GD10.1, GD11.1, GD12.1, GT9.P$3, GT10.P$3, GT11.P$3, GT12.P$3, IC17.11, IC18.5, IC19.4, IC19.10, IC20.4, IC21.2, IC21.4, IC22.8, IC23.1, IC24.2, MIDIOUT2.P$3, OFF2.3, ON2.3, PWR2.K, R70.2, R82.1, R83.1, R84.1, R85.1, R87.1, R98.1, R99.1, R102.1
GND3: AUXI3.P$3, AUXO3.P$3, BT-3.1, C67.2, C68.2, C69.-, C70.2, C71.-, C73.-, C74.-, C75.2, C76.1, C77.-, C78.2, C83.1, C84.1, C85.1, C86.1, C87.1, C88.1, CKI3.P$3, CKO3.P$3, CVA3.P$3, CVB3.P$3, CVC3.P$3, CVD3.P$3, D28.C, D31.C, D32.A, DC3.PIN, GD13.1, GD14.1, GD15.1, GD16.1, GT13.P$3, GT14.P$3, GT15.P$3, GT16.P$3, IC25.11, IC26.5, IC27.4, IC27.10, IC28.4, IC29.2, IC29.4, IC30.8, IC31.1, IC32.2, MIDIOUT3.P$3, OFF3.3, ON3.3, PWR3.K, R104.2, R116.1, R117.1, R118.1, R119.1, R121.1, R132.1, R133.1, R136.1
GND4: AUXI4.P$3, AUXO4.P$3, BT-4.1, C89.2, C90.2, C91.-, C92.2, C93.-, C95.-, C96.-, C97.2, C98.1, C99.-, C100.2, C105.1, C106.1, C107.1, C108.1, C109.1, C110.1, CKI4.P$3, CKO4.P$3, CVA4.P$3, CVB4.P$3, CVC4.P$3, CVD4.P$3, D36.C, D39.C, D40.A, DC4.PIN, GD17.1, GD18.1, GD19.1, GD20.1, GT17.P$3, GT18.P$3, GT19.P$3, GT20.P$3, IC33.11, IC34.5, IC35.4, IC35.10, IC36.4, IC37.2, IC37.4, IC38.8, IC39.1, IC40.2, MIDIOUT4.P$3, OFF4.3, ON4.3, PWR4.K, R138.2, R150.1, R151.1, R152.1, R153.1, R155.1, R166.1, R167.1, R170.1
MIDI_IN: IC1.6, R4.1, RX.1
MIDI_IN1: IC10.6, R37.1, RX1.1
MIDI_IN2: IC18.6, R71.1, RX2.1
MIDI_IN3: IC26.6, R105.1, RX3.1
MIDI_IN4: IC34.6, R139.1, RX4.1
MIDI_OUT: R2.2, TX.1
MIDI_OUT1: R39.2, TX1.1
MIDI_OUT2: R73.2, TX2.1
MIDI_OUT3: R107.2, TX3.1
MIDI_OUT4: R141.2, TX4.1
unnamed: MIDIOUT.P$2, R1.1
unnamed: D1.A, IC1.2, R3.2
unnamed: IC4.3, IC5.7
unnamed: D1.C, IC1.3, MIDIIN.P$1
unnamed: IC1.7, R5.1
unnamed: MIDIOUT.P$1, R2.1
unnamed: MIDIIN.P$2, R3.1
unnamed: CVC.P$1, R16.2, R17.2
unnamed: CVD.P$1, R25.2, R27.2
unnamed: CVB.P$1, R19.2, R21.2
unnamed: CVA.P$1, R23.2, R24.2
unnamed: C13.2, IC4.1, R16.1
unnamed: C15.2, IC4.7, R27.1
unnamed: C17.2, IC4.8, R24.1
unnamed: C16.2, IC4.14, R19.1
unnamed: BT+.1, DC.NC
unnamed: C16.1, IC4.13, R20.2, R21.1
unnamed: C17.1, IC4.9, R22.2, R23.1
unnamed: IC6.10, R15.1
unnamed: C15.1, IC4.6, R25.1, R26.2
unnamed: D9.A, IC10.2, R35.2
unnamed: C13.1, IC4.2, R17.1, R18.2
unnamed: CLKIN.1, IC2.6
unnamed: AUXI.P$1, R8.2, R9.2
unnamed: IC2.4, RSIN.1
unnamed: D4.C, D5.A, IC2.3, R9.1
unnamed: C12.2, GT2.P$1, R15.2
unnamed: D9.C, IC10.3, MIDIIN1.P$1
unnamed: IC4.5, IC5.6
unnamed: IC4.10, IC5.9
unnamed: IC4.12, IC5.8
unnamed: IC7.1, IC7.7, IC7.8, R29.2
unnamed: IC7.5, R30.2, R31.2
unnamed: C21.1, IC7.3
unnamed: D7.C, IC7.2, L2.2
unnamed: D8.A, DC.BARREL
unnamed: IC6.2, R10.1
unnamed: C3.+, IC3.6
unnamed: C3.-, IC3.3
unnamed: IC6.4, R11.1
unnamed: IC6.6, R12.1
unnamed: IC10.7, R36.1
unnamed: IC6.12, R14.1
unnamed: AUXO.P$1, C5.2, R10.2
unnamed: C6.2, CKO.P$1, R11.2
unnamed: C7.2, GT1.P$1, R12.2
unnamed: C11.2, GT4.P$1, R14.2
unnamed: C10.2, GT3.P$1, R13.2
unnamed: IC6.15, R13.1
unnamed: MIDIOUT1.P$1, R39.1
unnamed: C20.+, L1.1, L2.1, R31.1
unnamed: CVC1.P$1, R40.2, R44.2
unnamed: D2.A, D3.C, IC2.1, R7.1
unnamed: CKI.P$1, R6.2, R7.2
unnamed: CVD1.P$1, R41.2, R45.2
unnamed: PWR.A, R28.2
unnamed: C35.2, IC9.1, R40.1
unnamed: C36.2, IC9.7, R41.1
unnamed: C37.2, IC9.8, R42.1
unnamed: C38.2, IC9.14, R43.1
unnamed: IC8.4, IC8.7, IC8.8, ON.2, R34.2
unnamed: IC8.2, R32.2, R33.2
unnamed: C38.1, IC9.13, R47.1, R51.2
unnamed: C37.1, IC9.9, R46.1, R50.2
unnamed: C36.1, IC9.6, R45.1, R49.2
unnamed: C35.1, IC9.2, R44.1, R48.2
unnamed: IC9.10, IC11.9
unnamed: IC9.12, IC11.8
unnamed: IC12.1, IC12.7, IC12.8, R52.2
unnamed: C26.1, IC12.3
unnamed: D16.C, IC12.2, L4.2
unnamed: IC12.5, R53.2, R54.2
unnamed: C28.+, IC13.6
unnamed: C28.-, IC13.3
unnamed: D13.A, DC1.BARREL
unnamed: CVB1.P$1, R43.2, R47.2
unnamed: CVA1.P$1, R42.2, R46.2
unnamed: IC14.2, R55.1
unnamed: IC14.4, R56.1
unnamed: IC14.6, R57.1
unnamed: IC14.12, R58.1
unnamed: AUXO1.P$1, C39.2, R55.2
unnamed: C40.2, CKO1.P$1, R56.2
unnamed: C41.2, GT6.P$1, R57.2
unnamed: C42.2, GT7.P$1, R58.2
unnamed: C43.2, GT8.P$1, R59.2
unnamed: IC14.15, R59.1
unnamed: D11.C, D12.A, IC16.1, R60.1
unnamed: CKI1.P$1, R60.2, R65.2
unnamed: PWR1.A, R61.2
unnamed: IC15.4, IC15.7, IC15.8, ON1.2, R62.2
unnamed: IC15.2, R63.2, R64.2
unnamed: IC9.3, IC11.7
unnamed: IC9.5, IC11.6
unnamed: C27.+, L3.1, L4.1, R54.1
unnamed: MIDIIN1.P$2, R35.1
unnamed: MIDIOUT1.P$2, R38.1
unnamed: BT+1.1, DC1.NC
unnamed: IC14.10, R66.1
unnamed: AUXI1.P$1, R67.2, R68.2
unnamed: D14.C, D15.A, IC16.3, R67.1
unnamed: IC16.4, RSIN1.1
unnamed: CLKIN1.1, IC16.6
unnamed: C44.2, GT5.P$1, R66.2
unnamed: D17.A, IC18.2, R69.2
unnamed: D17.C, IC18.3, MIDIIN2.P$1
unnamed: IC18.7, R70.1
unnamed: MIDIOUT2.P$1, R73.1
unnamed: CVC2.P$1, R74.2, R78.2
unnamed: CVD2.P$1, R75.2, R79.2
unnamed: C57.2, IC17.1, R74.1
unnamed: C58.2, IC17.7, R75.1
unnamed: C59.2, IC17.8, R76.1
unnamed: C60.2, IC17.14, R77.1
unnamed: C60.1, IC17.13, R81.1, R85.2
unnamed: C59.1, IC17.9, R80.1, R84.2
unnamed: C58.1, IC17.6, R79.1, R83.2
unnamed: C57.1, IC17.2, R78.1, R82.2
unnamed: IC17.10, IC19.9
unnamed: IC17.12, IC19.8
unnamed: IC20.1, IC20.7, IC20.8, R86.2
unnamed: C48.1, IC20.3
unnamed: D24.C, IC20.2, L6.2
unnamed: IC20.5, R87.2, R88.2
unnamed: C50.+, IC21.6
unnamed: C50.-, IC21.3
unnamed: D21.A, DC2.BARREL
unnamed: CVB2.P$1, R77.2, R81.2
unnamed: CVA2.P$1, R76.2, R80.2
unnamed: IC22.2, R89.1
unnamed: IC22.4, R90.1
unnamed: IC22.6, R91.1
unnamed: IC22.12, R92.1
unnamed: AUXO2.P$1, C61.2, R89.2
unnamed: C62.2, CKO2.P$1, R90.2
unnamed: C63.2, GT10.P$1, R91.2
unnamed: C64.2, GT11.P$1, R92.2
unnamed: C65.2, GT12.P$1, R93.2
unnamed: IC22.15, R93.1
unnamed: D19.C, D20.A, IC24.1, R94.1
unnamed: CKI2.P$1, R94.2, R99.2
unnamed: PWR2.A, R95.2
unnamed: IC23.4, IC23.7, IC23.8, ON2.2, R96.2
unnamed: IC23.2, R97.2, R98.2
unnamed: IC17.3, IC19.7
unnamed: IC17.5, IC19.6
unnamed: C49.+, L5.1, L6.1, R88.1
unnamed: MIDIIN2.P$2, R69.1
unnamed: MIDIOUT2.P$2, R72.1
unnamed: BT+2.1, DC2.NC
unnamed: IC22.10, R100.1
unnamed: AUXI2.P$1, R101.2, R102.2
unnamed: D22.C, D23.A, IC24.3, R101.1
unnamed: IC24.4, RSIN2.1
unnamed: CLKIN2.1, IC24.6
unnamed: C66.2, GT9.P$1, R100.2
unnamed: D25.A, IC26.2, R103.2
unnamed: D25.C, IC26.3, MIDIIN3.P$1
unnamed: IC26.7, R104.1
unnamed: MIDIOUT3.P$1, R107.1
unnamed: CVC3.P$1, R108.2, R112.2
unnamed: CVD3.P$1, R109.2, R113.2
unnamed: C79.2, IC25.1, R108.1
unnamed: C80.2, IC25.7, R109.1
unnamed: C81.2, IC25.8, R110.1
unnamed: C82.2, IC25.14, R111.1
unnamed: C82.1, IC25.13, R115.1, R119.2
unnamed: C81.1, IC25.9, R114.1, R118.2
unnamed: C80.1, IC25.6, R113.1, R117.2
unnamed: C79.1, IC25.2, R112.1, R116.2
unnamed: IC25.10, IC27.9
unnamed: IC25.12, IC27.8
unnamed: IC28.1, IC28.7, IC28.8, R120.2
unnamed: C70.1, IC28.3
unnamed: D32.C, IC28.2, L8.2
unnamed: IC28.5, R121.2, R122.2
unnamed: C72.+, IC29.6
unnamed: C72.-, IC29.3
unnamed: D29.A, DC3.BARREL
unnamed: CVB3.P$1, R111.2, R115.2
unnamed: CVA3.P$1, R110.2, R114.2
unnamed: IC30.2, R123.1
unnamed: IC30.4, R124.1
unnamed: IC30.6, R125.1
unnamed: IC30.12, R126.1
unnamed: AUXO3.P$1, C83.2, R123.2
unnamed: C84.2, CKO3.P$1, R124.2
unnamed: C85.2, GT14.P$1, R125.2
unnamed: C86.2, GT15.P$1, R126.2
unnamed: C87.2, GT16.P$1, R127.2
unnamed: IC30.15, R127.1
unnamed: D27.C, D28.A, IC32.1, R128.1
unnamed: CKI3.P$1, R128.2, R133.2
unnamed: PWR3.A, R129.2
unnamed: IC31.4, IC31.7, IC31.8, ON3.2, R130.2
unnamed: IC31.2, R131.2, R132.2
unnamed: IC25.3, IC27.7
unnamed: IC25.5, IC27.6
unnamed: C71.+, L7.1, L8.1, R122.1
unnamed: MIDIIN3.P$2, R103.1
unnamed: MIDIOUT3.P$2, R106.1
unnamed: BT+3.1, DC3.NC
unnamed: IC30.10, R134.1
unnamed: AUXI3.P$1, R135.2, R136.2
unnamed: D30.C, D31.A, IC32.3, R135.1
unnamed: IC32.4, RSIN3.1
unnamed: CLKIN3.1, IC32.6
unnamed: C88.2, GT13.P$1, R134.2
unnamed: D33.A, IC34.2, R137.2
unnamed: D33.C, IC34.3, MIDIIN4.P$1
unnamed: IC34.7, R138.1
unnamed: MIDIOUT4.P$1, R141.1
unnamed: CVC4.P$1, R142.2, R146.2
unnamed: CVD4.P$1, R143.2, R147.2
unnamed: C101.2, IC33.1, R142.1
unnamed: C102.2, IC33.7, R143.1
unnamed: C103.2, IC33.8, R144.1
unnamed: C104.2, IC33.14, R145.1
unnamed: C104.1, IC33.13, R149.1, R153.2
unnamed: C103.1, IC33.9, R148.1, R152.2
unnamed: C102.1, IC33.6, R147.1, R151.2
unnamed: C101.1, IC33.2, R146.1, R150.2
unnamed: IC33.10, IC35.9
unnamed: IC33.12, IC35.8
unnamed: IC36.1, IC36.7, IC36.8, R154.2
unnamed: C92.1, IC36.3
unnamed: D40.C, IC36.2, L10.2
unnamed: IC36.5, R155.2, R156.2
unnamed: C94.+, IC37.6
unnamed: C94.-, IC37.3
unnamed: D37.A, DC4.BARREL
unnamed: CVB4.P$1, R145.2, R149.2
unnamed: CVA4.P$1, R144.2, R148.2
unnamed: IC38.2, R157.1
unnamed: IC38.4, R158.1
unnamed: IC38.6, R159.1
unnamed: IC38.12, R160.1
unnamed: AUXO4.P$1, C105.2, R157.2
unnamed: C106.2, CKO4.P$1, R158.2
unnamed: C107.2, GT18.P$1, R159.2
unnamed: C108.2, GT19.P$1, R160.2
unnamed: C109.2, GT20.P$1, R161.2
unnamed: IC38.15, R161.1
unnamed: D35.C, D36.A, IC40.1, R162.1
unnamed: CKI4.P$1, R162.2, R167.2
unnamed: PWR4.A, R163.2
unnamed: IC39.4, IC39.7, IC39.8, ON4.2, R164.2
unnamed: IC39.2, R165.2, R166.2
unnamed: IC33.3, IC35.7
unnamed: IC33.5, IC35.6
unnamed: C93.+, L9.1, L10.1, R156.1
unnamed: MIDIIN4.P$2, R137.1
unnamed: MIDIOUT4.P$2, R140.1
unnamed: BT+4.1, DC4.NC
unnamed: IC38.10, R168.1
unnamed: AUXI4.P$1, R169.2, R170.2
unnamed: D38.C, D39.A, IC40.3, R169.1
unnamed: IC40.4, RSIN4.1
unnamed: CLKIN4.1, IC40.6
unnamed: C110.2, GT17.P$1, R168.2
OFF_SW: OFF.2, OFFSW.1
OFF_SW1: OFF1.2, OFFSW1.1
OFF_SW2: OFF2.2, OFFSW2.1
OFF_SW3: OFF3.2, OFFSW3.1
OFF_SW4: OFF4.2, OFFSW4.1
PWR_CTRL: PWRCTL.1, R33.1
PWR_CTRL1: PWRCTL1.1, R63.1
PWR_CTRL2: PWRCTL2.1, R97.1
PWR_CTRL3: PWRCTL3.1, R131.1
PWR_CTRL4: PWRCTL4.1, R165.1
SCL: IC5.2, SCL.1
SCL1: IC11.2, SCL1.1
SCL2: IC19.2, SCL2.1
SCL3: IC27.2, SCL3.1
SCL4: IC35.2, SCL4.1
SDA: IC5.3, SDA.1
SDA1: IC11.3, SDA1.1
SDA2: IC19.3, SDA2.1
SDA3: IC27.3, SDA3.1
SDA4: IC35.3, SDA4.1
VIN: D8.C, IC8.3, R34.1
VIN1: D13.C, IC15.3, R62.1
VIN2: D21.C, IC23.3, R96.1
VIN3: D29.C, IC31.3, R130.1
VIN4: D37.C, IC39.3, R164.1
