hotchk155/noodlebox_io_board/(commit log)

2019-05-19 changes for rev2
    [matrix_io_board.brd, matrix_io_board.sch]
2019-05-27 version 2 ready for fab
    [matrix_io_board.brd]
2019-05-27 typo fix
    [matrix_io_board.brd]
2019-11-26 work in progress
    [matrix_io_board.brd, matrix_io_board.sch]
2019-11-26 V3 candidate
    [matrix_io_board.brd, matrix_io_board.sch]
2020-01-02 use the new stereo Thonk sockets
    [matrix_io_board.brd, matrix_io_board.sch]
2020-01-14 V4 ready to go
    [matrix_io_board.brd, matrix_io_board.sch]
2020-02-18 V5 first cut
    [matrix_io_board.brd, matrix_io_board.sch]
2020-02-26 V5 READY TO GO
    [matrix_io_board.brd, matrix_io_board.sch]
2020-02-26 eagle 6.6
    [matrix_io_board.brd, matrix_io_board.sch]
2022-04-22 3v3 updates
    [matrix_io_board.brd, matrix_io_board.sch]
2023-02-10 Revert "3v3 updates"
    This reverts commit 782c7fb22120100be74f5025aa682998f87b6e62.
    [matrix_io_board.brd, matrix_io_board.sch]
