hotchk155/noodlebox_io_board/(notices)

Notices in the files:
matrix_io_board.brd:
CC-BY-NC-SA
